Gautham-Dev007/pid-testbench/firmware/Core/Inc/main.h

#define BUZZER_Pin GPIO_PIN_10
#define BUZZER_GPIO_Port GPIOA
#define FAN2_DIR_Pin GPIO_PIN_9
#define FAN2_DIR_GPIO_Port GPIOA
#define RTD_CS_Pin GPIO_PIN_0
#define RTD_CS_GPIO_Port GPIOB
#define FAN1_DIR_Pin GPIO_PIN_14
#define FAN1_DIR_GPIO_Port GPIOB
