Gautham-Dev007/pid-testbench/firmware/Core/Inc/iwdg.h

#ifndef __IWDG_H__
#define __IWDG_H__

#ifdef __cplusplus
extern "C" {
#endif

#include "main.h"

extern IWDG_HandleTypeDef hiwdg;

void MX_IWDG_Init(void);

#ifdef __cplusplus
}
#endif

#endif /* __IWDG_H__ */
