Gautham-Dev007/pid-testbench/firmware/Core/Inc/tim.h

#ifndef __TIM_H__
#define __TIM_H__

#ifdef __cplusplus
extern "C" {
#endif

#include "main.h"

extern TIM_HandleTypeDef htim1;
extern TIM_HandleTypeDef htim3;
extern TIM_HandleTypeDef htim6;

void MX_TIM1_Init(void);
void MX_TIM3_Init(void);
void MX_TIM6_Init(void);

void HAL_TIM_MspPostInit(TIM_HandleTypeDef *htim);

#ifdef __cplusplus
}
#endif

#endif /* __TIM_H__ */
