Gautham-Dev007/pid-testbench/firmware/Core/Inc/usart.h

#ifndef __USART_H__
#define __USART_H__

#ifdef __cplusplus
extern "C" {
#endif

#include "main.h"

extern UART_HandleTypeDef huart2;

void MX_USART2_UART_Init(void);

#ifdef __cplusplus
}
#endif

#endif /* __USART_H__ */
